ejramas/TT_RAM-SRAM-Sense_Amp/test/LTSpice/CMOS_Sense_Amp.asc

M1: pmos4; pch; l={inv_p_length} w={inv_p_width} m={mult}
M2: nmos4; nch; l={inv_n_length} w={inv_n_width} m={mult}
M3: pmos4; pch; l={inv_p_length} w={inv_p_width} m={mult}
M4: nmos4; nch; l={inv_n_length} w={inv_n_width} m={mult}
M5: nmos4; nch; l=180n w=1u
M6: nmos4; nch; l=180n w=1u
M7: pmos4; pch; l={csrc_length} w={csrc_width}
M8: pmos4; pch; l={csrc_length} w={csrc_width}
R1: res; 5k
R4: res; 50
R5: res; 50
V1: voltage; {VDD}
Vcm: voltage; {Vcm}
Vsig+: voltage; PULSE({Vlow} {Vhigh} {td} {tr} {tf} {ton} {Tp}); AC 0.5 0
Vsig-: voltage; PULSE({Vlow} {Vhigh} {td} {tr} {tf} {ton} {Tp}); AC 0.5 0
Named nets: 0, Vdd, in_p, in_m, v_cm, out_p, out_m, vdp, vsn, vsp
.lib 'C:\\Users\\ernes\\OneDrive\\Documents\\LTspice\\ECE298A\\mos018.l' TT
.param Vlow=-Vp
.tran 0 100e-9 0 1e-11
.op
.param Vhigh=Vp
.param Vp=100m
.param fp=66e6
.param td=0
.param tr=1e-10
.param tf=tr
.param ton=Tp/2-tr
.param Tp=1/fp
Differential voltage from 900mV ->
Differential voltage sources ->
Frequency of pulses ->
Square wave delay before starting ->
Rise time ->
Fall time ->
On time ->
Period calculted from frequency ->
.param Vcm=0.9
Common mode voltage ->
Supply voltage:
.param VDD=1.8
.param Vcs=VDD-Vds
Current source PMOS gate voltage ->
inv. PMOS length:
.param inv_p_length=500n
inv. NMOS width:
.param inv_n_length=inv_p_length
inv. PMOS width:
.param inv_p_width=7u
inv. NMOS length:
.param inv_n_width=(inv_p_width/5)
feedback NMOS length:
feedback NMOS width:
.param fb_width=1u
.param fb_length=default_length
current src length:
current src width:
.param csrc_length=default_length
.param csrc_width=10u
.param default_length=180n
min width 1u
min length 180n
.param Vds=0.7
Current source gate voltage, current source width, and feedback NMOS width
all affect common mode voltage.
.ac dec 51 1k 1G
.step param inv_p_width 5u 15u 1u
.step param I_in 220u 260u 5u
.step param Vcm 0.5 1.4 0.1
.step param R_test 4k 10k 500
.dc Vcm .5 1.8 0.01
multiplicity:
.param mult=1
.step param mult 1 16 1
.step param csrc_width 5u 50u 5u
.step param inv_p_length 200n 2u 50n
.step param Vp 10m 400m 20m
